fwachsmuth/rooDialino/README.md

# rooDialino
