fwachsmuth/rooDialino/rooDialino-KiCad/2021-10-18 at 21.24.png

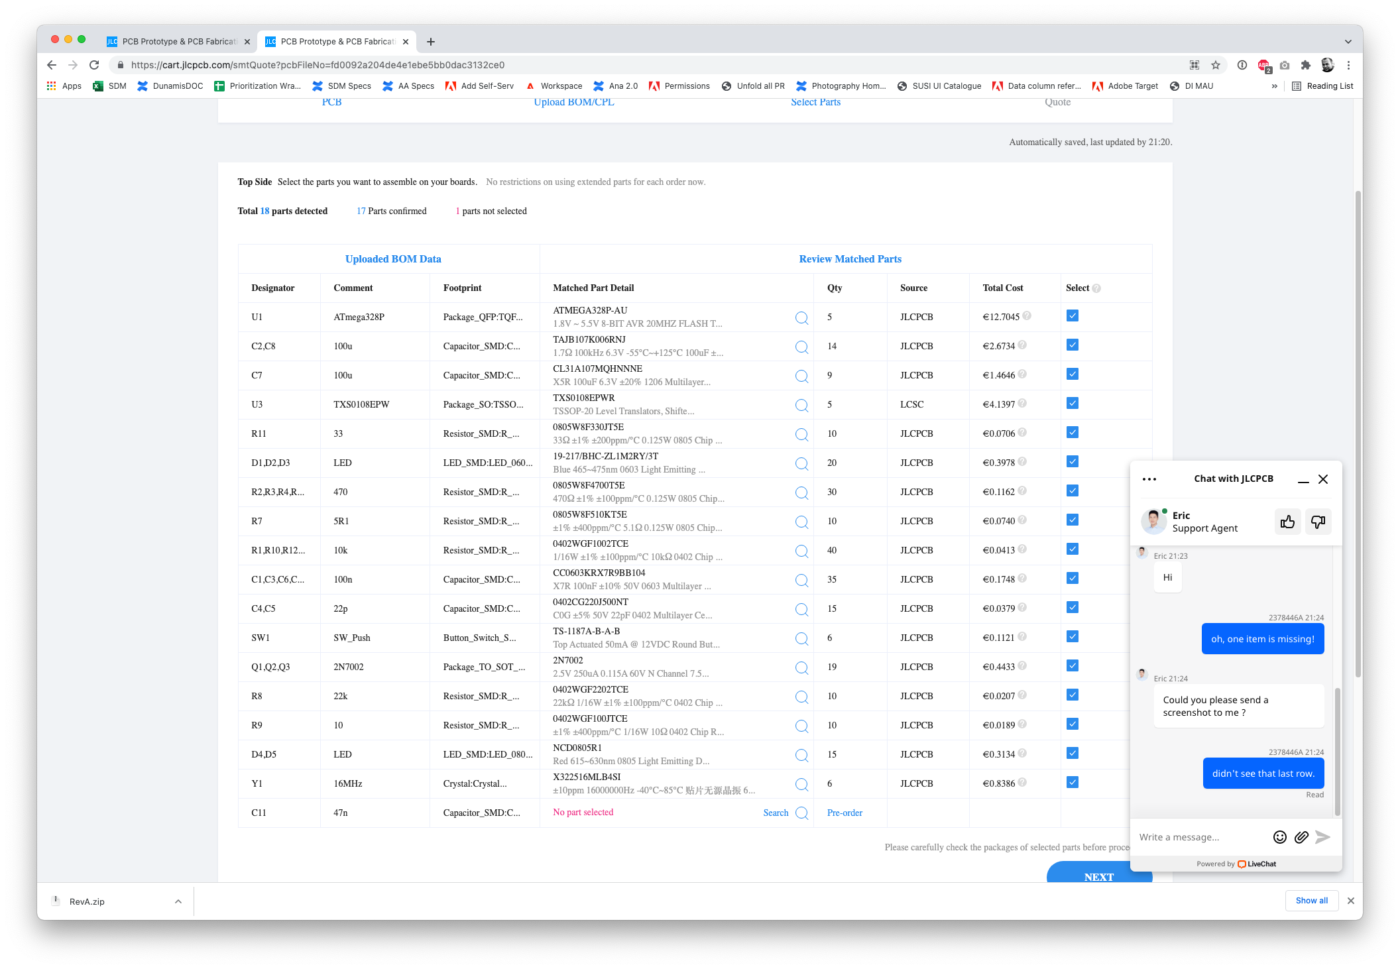
rooDialino-KiCad/2021-10-18 at 21.24.png
