fwachsmuth/rooDialino/rooDialino-KiCad/THT Parts yet to order.xlsx

Designator | Comment | Footprint | Quantity
J5 | IR LED | CONNECTOR_PINHEADER_2.54MM:PINHEADER_1X02_P2.54MM_VERTICAL | 0
J1 | RASPI CONNECTOR | CONNECTOR_PINSOCKET_2.54MM:PINSOCKET_2X20_P2.54MM_VERTICAL | 0
J2 | ICSP | CONNECTOR_PINHEADER_2.54MM:PINHEADER_2X03_P2.54MM_VERTICAL | 0
D6,D8 | LED | LED_THT:LED_D5.0MM_HORIZONTAL_O1.27MM_Z3.0MM_IRBLACK | 0
U2 | TSOP312XX | OPTODEVICE:VISHAY_MINICAST-3PIN | 0
D7 | LED | LED_THT:LED_D5.0MM_IRBLACK | 0
J3 | FTDI | CONNECTOR_PINHEADER_2.54MM:PINHEADER_1X06_P2.54MM_VERTICAL | 0
J4 | IR RECEIVER | CONNECTOR_PINHEADER_2.54MM:PINHEADER_1X03_P2.54MM_VERTICAL | 0
DESIGNATOR | COMMENT | FOOTPRINT | 0
