fwachsmuth/rooDialino/rooDialino-KiCad/roodialino.kicad_pcb

## KiCad design rooDialino-KiCad/roodialino.kicad_pcb (2021-10-25)

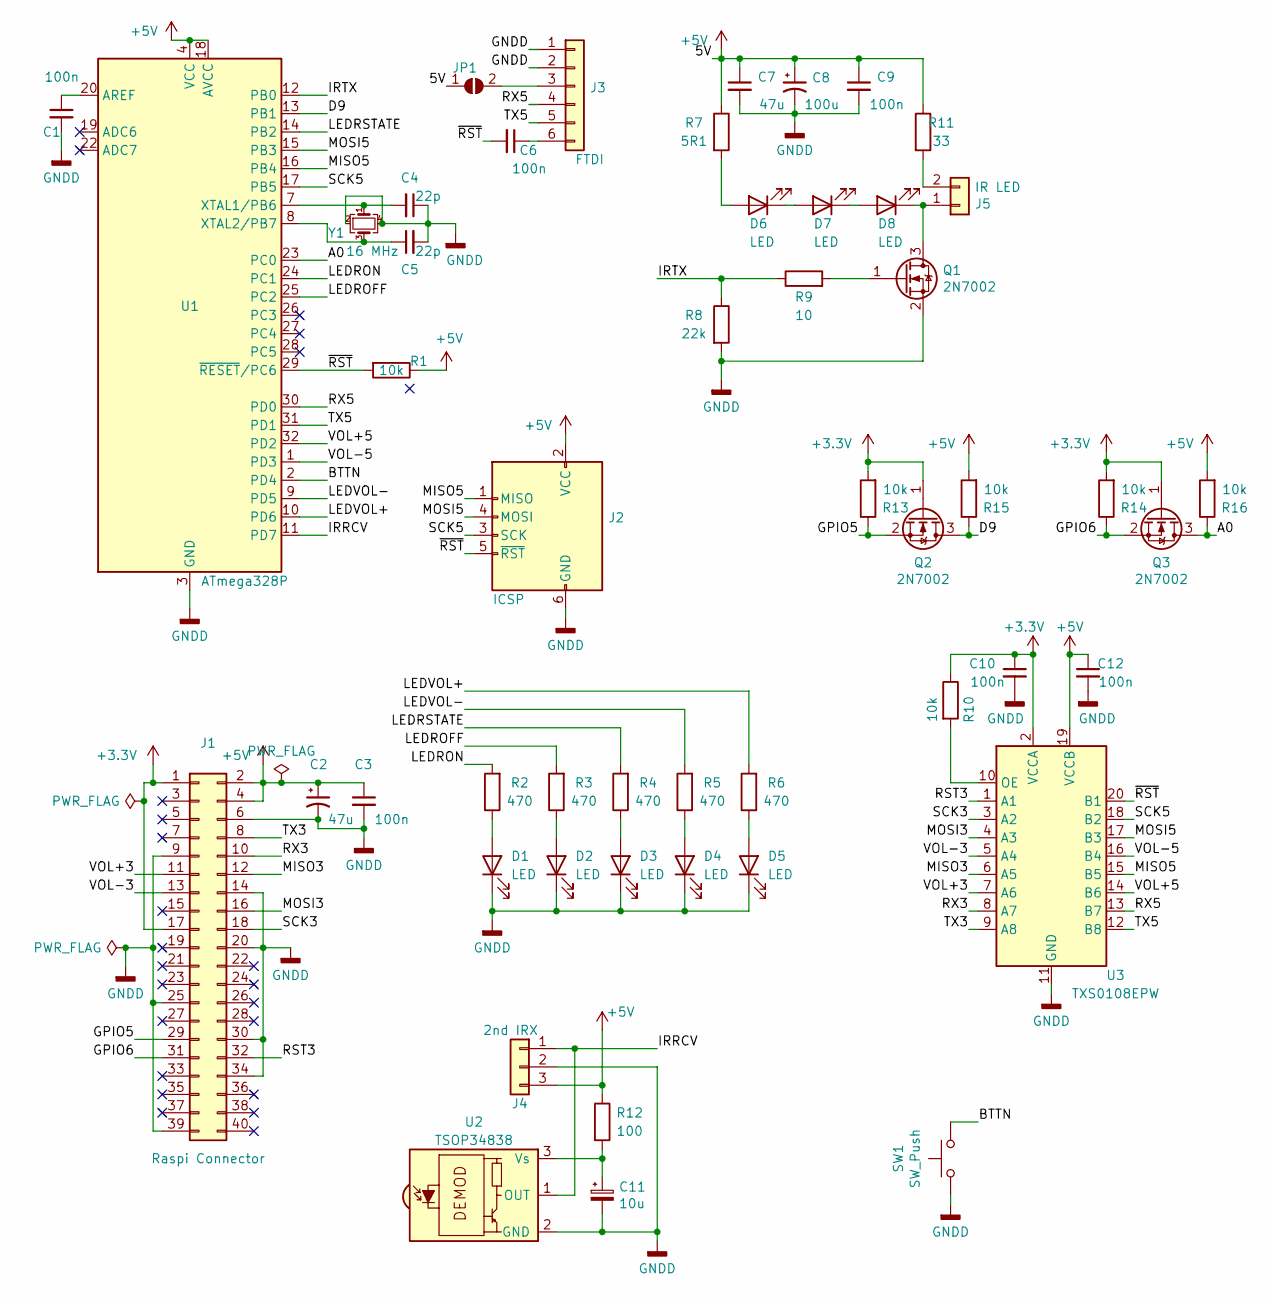
[picture p2: schematic roodialino.kicad_sch]

Parts:
C1: 100n; C_0603_1608Metric; LCSC C14663
C2: 47u; CP_Elec_4x5.8; LCSC C178589
C3, C6, C9, C10, C12: 100n; C_0402_1005Metric; LCSC C1525
C4, C5: 22p; C_0402_1005Metric; LCSC C1555
C7: 47u; C_1206_3216Metric; LCSC C15008
C8: 100u; CP_Elec_4x5.8; LCSC C178589
C11: 10u; CP_EIA-3216-18_Kemet-A; LCSC C7171
D1, D2, D3: LED; LED_0603_1608Metric; LCSC C72041
D4: LED; LED_0603_1608Metric; LCSC C72038
D5: LED; LED_0603_1608Metric; LCSC C72043
D6, D8: LED; LED_D5.0mm_Horizontal_O1.27mm_Z3.0mm_IRBlack; LCSC C55528
D7: LED; LED_D5.0mm_IRBlack; LCSC C55528
J1: Raspi Connector; PinSocket_2x20_P2.54mm_Vertical
J2: ICSP; PinHeader_2x03_P2.54mm_Vertical
J3: FTDI; PinHeader_1x06_P2.54mm_Vertical
J4: 2nd IRX; PinHeader_1x03_P2.54mm_Vertical
J5: IR LED; PinHeader_1x02_P2.54mm_Vertical
JP1: SolderJumper_2_Open; SolderJumper-2_P1.3mm_Open_RoundedPad1.0x1.5mm
Q1, Q2, Q3: 2N7002; SOT-23; LCSC C8545
R1, R10, R13, R14, R15, R16: 10k; R_0402_1005Metric; LCSC C25744
R2, R3, R4, R5, R6: 470; R_0402_1005Metric; LCSC C25117
R7: 5R1; R_0805_2012Metric; LCSC C17724
R8: 22k; R_0402_1005Metric
R9: 10; R_0402_1005Metric
R11: 33; R_0603_1608Metric; LCSC C23140
R12: 100; R_0402_1005Metric; LCSC C25076
SW1: SW_Push; SW_SPST_TL3342; LCSC C318884
U1: ATmega328P; TQFP-32_7x7mm_P0.8mm; LCSC C14877
U2: TSOP34838; Vishay_MOLD-3Pin; LCSC C44620
U3: TXS0108EPW; TSSOP-20_4.4x6.5mm_P0.65mm; LCSC C17206
Y1: 16 MHz; Crystal_SMD_3225-4Pin_3.2x2.5mm; LCSC C13738

Connections:
+3V3: C10.1, J1.1, J1.17, Q2.1 (G), Q3.1 (G), R10.1, R13.2, R14.2, U3.2 (VCCA)
+5V: C2.1, C3.1, C7.1, C8.1, C9.1, C12.1, J1.2, J1.4, J2.2 (VCC), J4.3, JP1.1 (A), R1.1, R7.1, R11.1, R12.1, R15.2, R16.2, U1.4 (VCC), U1.6 (VCC), U1.18 (AVCC), U3.19 (VCCB)
/A0: Q3.3 (D), R16.1, U1.23 (PC0)
/BTTN: SW1.2, U1.2 (PD4)
/D9: Q2.3 (D), R15.1, U1.13 (PB1)
/GPIO5: J1.29, Q2.2 (S), R13.1
/GPIO6: J1.31, Q3.2 (S), R14.1
/IRRCV: J4.1, U1.11 (PD7), U2.1 (OUT)
/IRTX: R8.1, R9.1, U1.12 (PB0)
/LEDROFF: R3.2, U1.25 (PC2)
/LEDRON: R2.2, U1.24 (PC1)
/LEDRSTATE: R4.2, U1.14 (PB2)
/LEDVOL+: R6.2, U1.10 (PD6)
/LEDVOL-: R5.2, U1.9 (PD5)
/MISO3: J1.12, U3.6 (A5)
/MISO5: J2.1 (MISO), U1.16 (PB4), U3.15 (B5)
/MOSI3: J1.16, U3.4 (A3)
/MOSI5: J2.4 (MOSI), U1.15 (PB3), U3.17 (B3)
/RST3: J1.32, U3.1 (A1)
/RX3: J1.10, U3.8 (A7)
/RX5: J3.4, U1.30 (PD0), U3.13 (B7)
/SCK3: J1.18, U3.3 (A2)
/SCK5: J2.3 (SCK), U1.17 (PB5), U3.18 (B2)
/TX3: J1.8, U3.9 (A8)
/TX5: J3.5, U1.31 (PD1), U3.12 (B8)
/VOL+3: J1.11, U3.7 (A6)
/VOL+5: U1.32 (PD2), U3.14 (B6)
/VOL-3: J1.13, U3.5 (A4)
/VOL-5: U1.1 (PD3), U3.16 (B4)
/~RST~: C6.2, J2.5 (~RST), R1.2, U1.29 (~RESET/PC6), U3.20 (B1)
GNDD: C1.2, C2.2, C3.2, C4.1, C5.2, C7.2, C8.2, C9.2, C10.2, C11.2, C12.2, D1.1 (K), D2.1 (K), D3.1 (K), D4.1 (K), D5.1 (K), J1.6, J1.9, J1.14, J1.20, J1.25, J1.30, J1.34, J1.39, J2.6 (GND), J3.1, J3.2, J4.2, Q1.2 (S), R8.2, SW1.1, U1.3 (GND), U1.5 (GND), U1.21 (GND), U2.2 (GND), U3.11 (GND), Y1.2, Y1.4
unnamed: C1.1, U1.20 (AREF)
unnamed: C4.2, U1.7 (XTAL1/PB6), Y1.1
unnamed: C5.1, U1.8 (XTAL2/PB7), Y1.3
unnamed: C6.1, J3.6
unnamed: C11.1, R12.2, U2.3 (Vs)
unnamed: D1.2 (A), R2.1
unnamed: D2.2 (A), R3.1
unnamed: D3.2 (A), R4.1
unnamed: D4.2 (A), R5.1
unnamed: D5.2 (A), R6.1
unnamed: D6.1 (K), D7.2 (A)
unnamed: D6.2 (A), R7.2
unnamed: D7.1 (K), D8.2 (A)
unnamed: D8.1 (K), J5.1, Q1.3 (D)
unnamed: J3.3, JP1.2 (B)
unnamed: J5.2, R11.2
unnamed: Q1.1 (G), R9.2
unnamed: R10.2, U3.10 (OE)

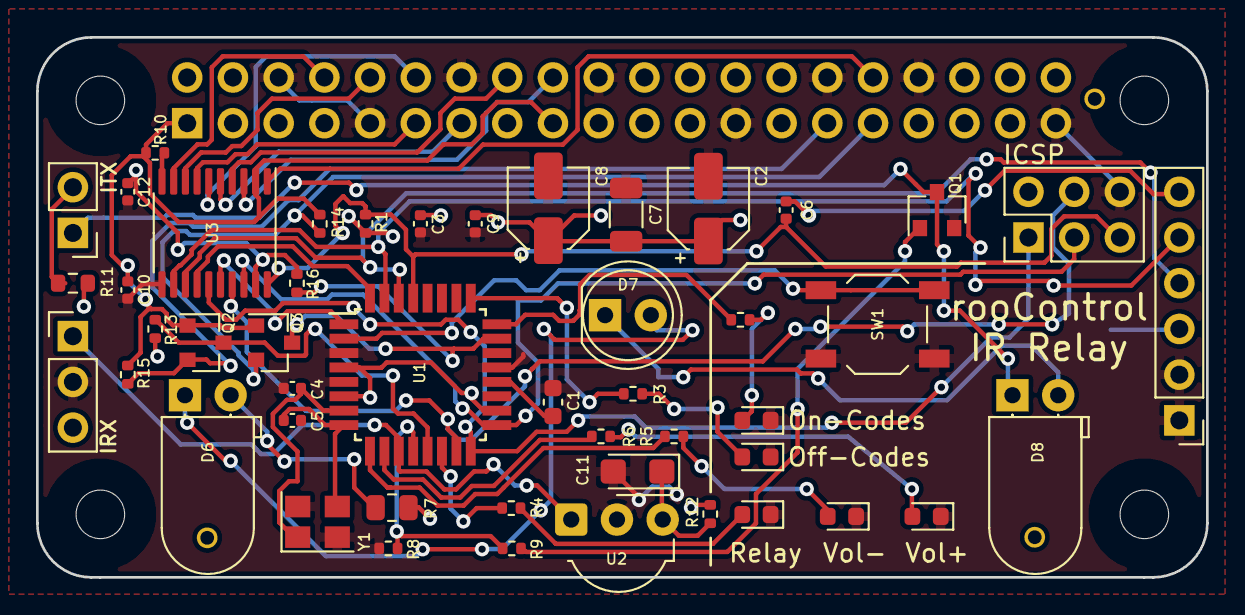
[picture p3: board roodialino.kicad_pcb from above]

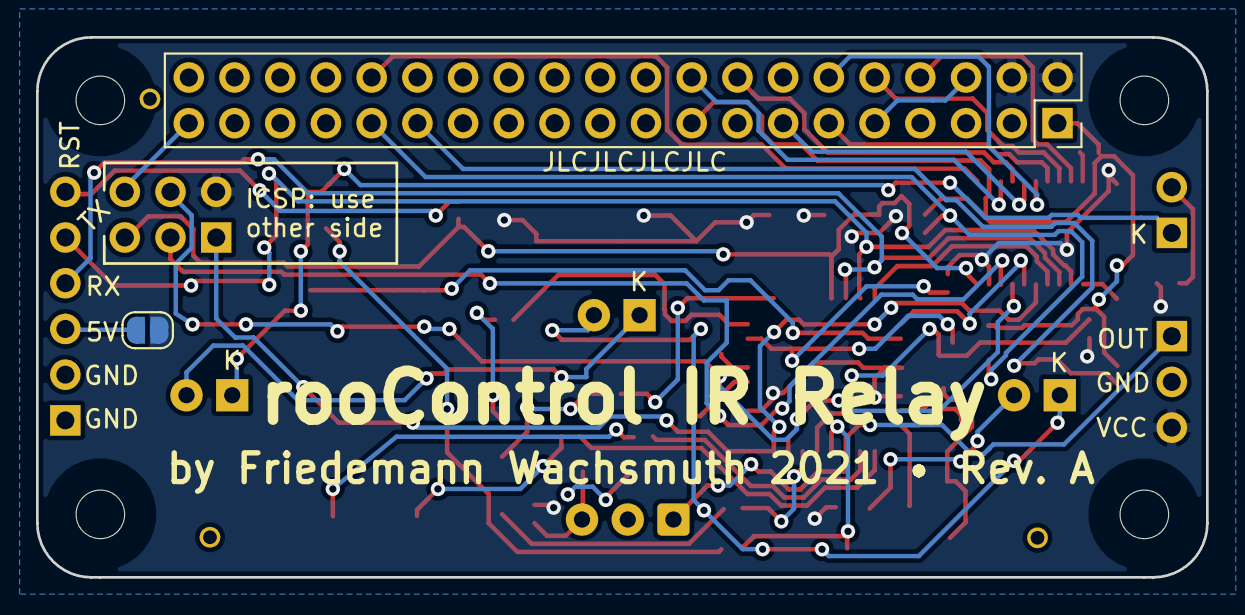
[picture p4: board roodialino.kicad_pcb from below]

Board: 2 copper layers, 65.0 x 30.0 mm, 54 parts (2 on the bottom side), 49 nets.

Other parts of the board:
H1, H2, H3, H4: MountingHole; MountingHole_2.7mm_M2.5_uHAT_RPi
