fwachsmuth/rooDialino/(threads)

Thread 1 (2021-10-04):

Omit use of delays

fwachsmuth, 2021-10-04:
Replace delay with some non-blocking logic – check if a certain amount of time has passed since the interrupt was last called, and if enough time has passed, actually handle the interrupt.
https://thewanderingengineer.com/2014/08/11/arduino-pin-change-interrupts/#comment-1592 looks handy

Thread 2 (2021-10-04):

Add On/Off Switch and State LED

fwachsmuth, 2021-10-04:
'coz we won't always want IR codes.

Thread 7 (2021-10-06):

Consider to support an "EnableRelay" Pin too

fwachsmuth, 2021-10-06:
This might be useful, so that certain roon zones could auto-disable relaying while selected — e.g. those with DSP volume control. GPIO22 should be good for this.

Thread 14 (2021-10-08):

Do not accept UNKNOWN Protocol when learning IR

fwachsmuth, 2021-10-08:
to compensate for noise from e.g. LED bulbs
