fwachsmuth/rooDialino/(commit log)

2021-10-04 Moving Todos to github issues
    [rooDialino.ino]
2021-10-04 Fixing stupi pin naming
    [rooDialino.ino]
2021-10-04 Fixing #5. No pulses are lost and we fire fast
    [rooDialino.ino]
2021-10-07 Scaffolding FSM, breaking down into missing pieces
    [rooDialino.ino]
2021-10-07 Cleaner FSM with dedicated transitionTo_FUNCTIONs. Also, fixes #6
    [rooDialino.ino]
2021-10-08 50% fixing the logic
    [rooDialino.ino]
2021-10-08 Fixing #12: Fix learnIRCode() to learn multiple things: needs a 250ms wait, needs to write different structs (struct array)
    [rooDialino.ino]
2021-10-09 Fixes #14: Do not accept UNKNOWN Protocol when learning IR
    [rooDialino.ino]
2021-10-09 Cleanup, working now, #16 still an issue
    [rooDialino.ino]
2021-10-09 Fixes #18. Inverse roll-over problem happening while millis() was <3000
    [rooDialino.ino]
2021-10-09 Fixes #9: save codes to EEPROM
    [rooDialino.ino]
2021-10-09 fixes #8: read codes from EEPROM
    [rooDialino.ino]
2021-10-09 Fixes an embarrassing array index bug
    [rooDialino.ino]
2021-10-09 saving current working state before refactoring out the nested struct fo raw data (mem & brain eater)
2021-10-09 Finally — selctive toggling works. Partially fixes #17
    [rooDialino.ino]
2021-10-14 Freeing up SPI pins currently used by LEDs — just to avoid conflicts during programming
    [rooDialino.ino]
2021-10-14 Adding KiCad WIP (Schematics only for now)
    [roodialino-import.sch, roodialino.kicad_pcb, roodialino.sch]
2021-10-14 More schematics
    [roodialino.sch]
2021-10-15 Footprints completed
    [roodialino.sch]
2021-10-15 all parts placed on board
    [roodialino.sch]
2021-10-16 More routing
    [roodialino.kicad_pcb, roodialino.sch]
2021-10-16 Nets complete!
    [roodialino.kicad_pcb]
2021-10-17 Looking good, that PCB
    [roodialino.kicad_pcb, roodialino.sch]
2021-10-18 First Gerber
    [roodialino-B_Cu.gbl, roodialino-B_Mask.gbs, roodialino-B_Paste.gbp, roodialino-B_SilkS.gbo, roodialino-Edge_Cuts.gm1, roodialino-F_Cu.gtl, roodialino-F_Mask.gts, roodialino-F_Paste.gtp]
2021-10-18 Fixing the crystal footprint
    [THT Parts yet to order.xlsx, default-header.csv, roodialino.csv, roodialino.kicad_pcb, roodialino.sch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]
2021-10-19 Fixes on the PCB
    [roodialino.kicad_pcb]
2021-10-19 enum for LED modes
2021-10-19 Better caps, less magic smoke!
    [roodialino.kicad_pcb, roodialino.sch]
2021-10-20 Removing debounce RC
    [roodialino.kicad_pcb, roodialino.sch]
2021-10-20 Tons of Trace Optimizations
    [roodialino.kicad_pcb]
2021-10-23 Levelshifter's OE gets permanently enabled. No need to ever have it low.
    [roodialino.kicad_pcb, roodialino.sch]
2021-10-23 Fixing IRX wiring, adding ESO protection
    [roodialino.sch]
2021-10-23 Saving before i size down some 0805s
    [roodialino.kicad_pcb, roodialino.sch]
2021-10-23 Reroute to 0402 complete. Also, bugs fixed
    [roodialino.kicad_pcb, roodialino.sch]
2021-10-23 More bugfixes
    [roodialino.kicad_pcb]
2021-10-23 DRC complete
    [roodialino.kicad_pcb]
2021-10-23 Some final (?) bling
    [roodialino.kicad_pcb, roodialino.sch]
2021-10-23 Rev A ready to Order!
    [roodialino-B_Cu.gbl, roodialino-B_Mask.gbs, roodialino-B_Paste.gbp, roodialino-B_SilkS.gbo, roodialino-Edge_Cuts.gm1, roodialino-F_Cu.gtl, roodialino-F_Mask.gts, roodialino-F_Paste.gtp]
2021-10-24 Add Tooling Holes
    [roodialino.kicad_pcb]
2021-10-25 The RevA I actually ordered.
    [roodialino-B_Cu.gbl, roodialino-B_Mask.gbs, roodialino-B_Paste.gbp, roodialino-B_SilkS.gbo, roodialino-Edge_Cuts.gm1, roodialino-F_Cu.gtl, roodialino-F_Mask.gts, roodialino-F_Paste.gtp]
2021-10-25 kicad save
    [roodialino.kicad_pcb]
2021-10-25 Wrapped all Serial.prints into DEBUG macro, since we'll later need the serial for comms
2021-10-26 Updating R11 to 0603 footprint in the BOM. JLC won't populate it.
    [roodialino.csv, roodialino.sch]
2021-10-26 LED Refactoring. Fixes #23 (with Todos) and prepares for two more LEDs
    [rooDialino.ino]
2021-10-26 Cleanup before going to bed
2021-10-27 Fixes Volume Direction, Sets Feedback LED back to normal once last IR pulse was sent
    [rooDialino.ino]
2021-10-27 Fixes #10 and #27
    [rooDialino.ino]
2021-10-27 minor cleanup and prep for more LEDs and Learn States
2021-10-29 just adding curly brackets for a one line if
2021-10-29 Flush cached Vol-Changes when the Relay gets turned off
2021-10-29 Code Celanup, some LED prep work
2021-10-29 Setting us up for 5 LEDS and new blinkenmodes (quadruple and quintuple)
2021-10-30 Refactored updateLeds() fn — thanks, kadiwa!
2021-10-31 Fixes Vol Down/Up Learn Order; Fixes Skip-per-Button Inconsistency; Add sLearning of two more (single) codes
    [rooDialino.ino]
2023-11-20 Uncommited Gruscht
    [roodialino.kicad_sch]
2023-11-20 Removing kicad backup garbage
    [default-header.csv, roodialino.csv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]
